Thugmek/ScintillatorProbe/Research/PMT Controller (Dec 2016)/PMT Controller (Dec 2016)/PHOTO/power supply wiring.JPG

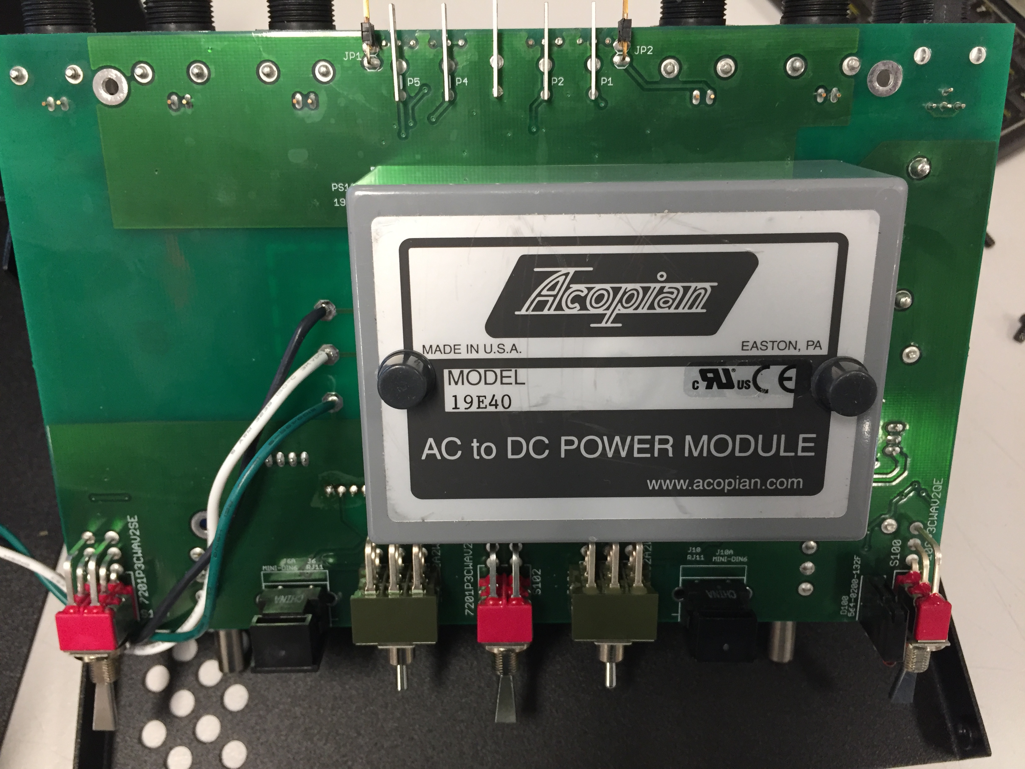
Research/PMT Controller (Dec 2016)/PMT Controller (Dec 2016)/PHOTO/power supply wiring.JPG
