Thugmek/ScintillatorProbe/ScintillatorProbeHardware/ScintillatorProbeHardware-brd.jpg

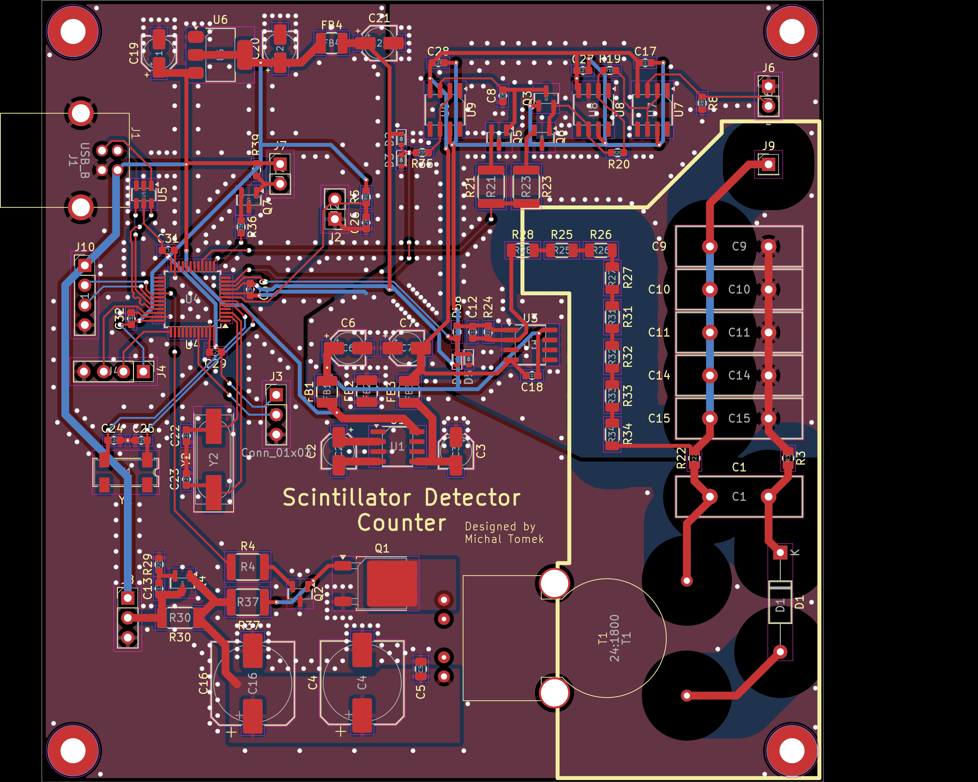
ScintillatorProbeHardware/ScintillatorProbeHardware-brd.jpg
