Thugmek/ScintillatorProbe/README.md

# Scintillator Gamma Detector

## License

All software in this repository is licensed under [GNU GPLv3](https://choosealicense.com/licenses/gpl-3.0/).
All hardware in this repository is licensed under [CERN OHL v2 Permissive](https://choosealicense.com/licenses/cern-ohl-p-2.0/).
