Thugmek/ScintillatorProbe/Research/PMT Controller (Dec 2016)/PMT Controller (Dec 2016)/PHOTO/frontpanel.JPG

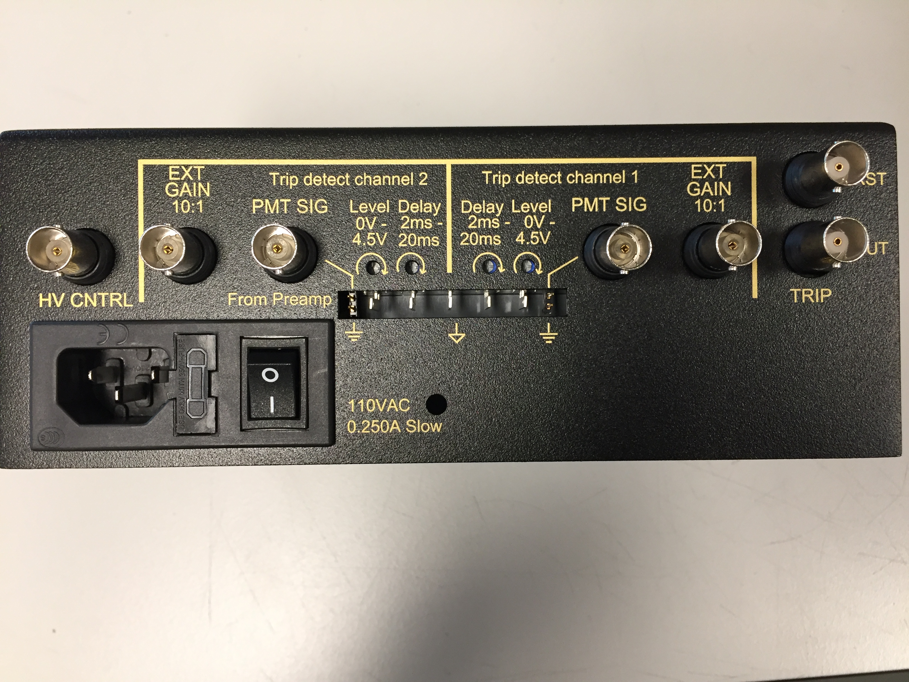
Research/PMT Controller (Dec 2016)/PMT Controller (Dec 2016)/PHOTO/frontpanel.JPG
