Thugmek/ScintillatorProbe/Research/PMT Controller (Dec 2016)/PMT Controller (Dec 2016)/PHOTO/rearpanel.JPG

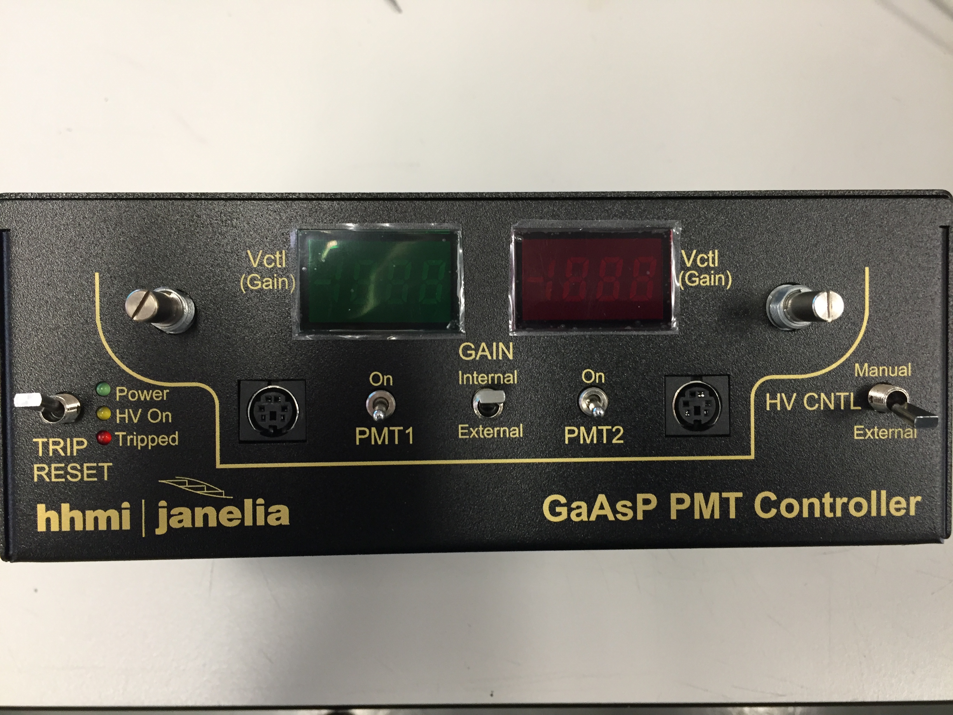
Research/PMT Controller (Dec 2016)/PMT Controller (Dec 2016)/PHOTO/rearpanel.JPG
