Thugmek/ScintillatorProbe/ScintillatorProbeHardware/schematic.png

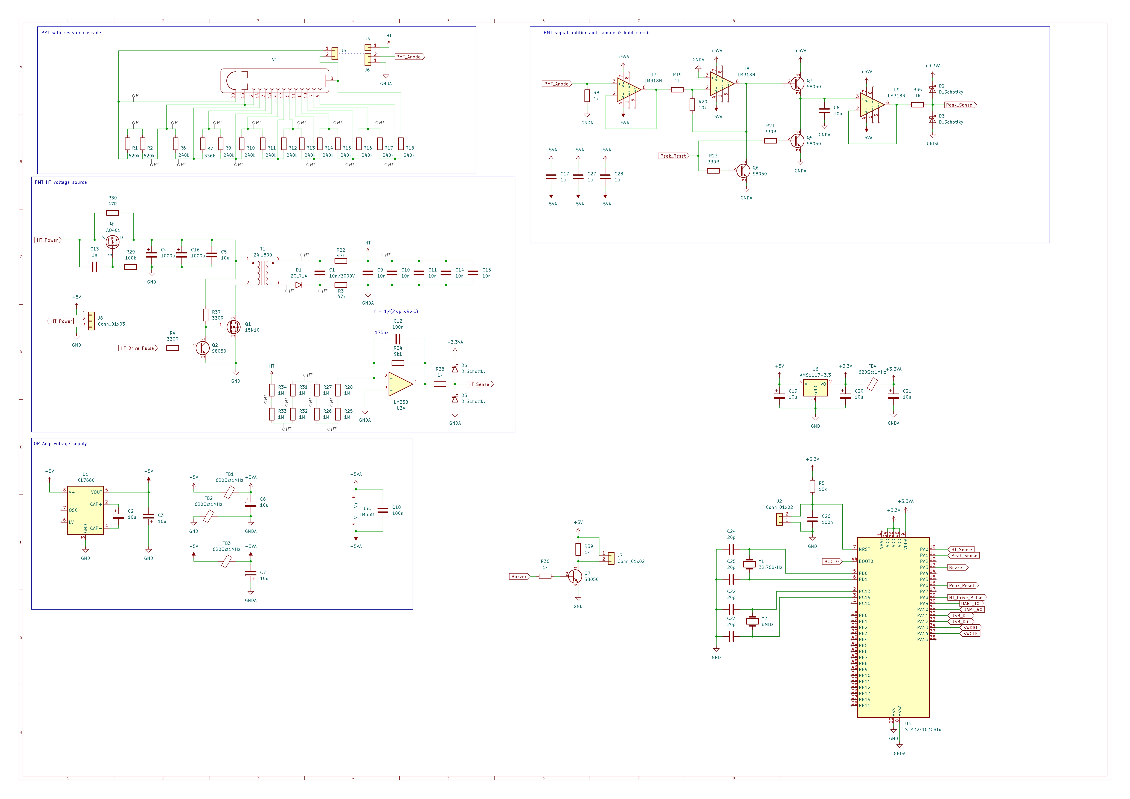
ScintillatorProbeHardware/schematic.png
