Thugmek/ScintillatorProbe/Research/PMT Controller (Dec 2016)/PMT Controller (Dec 2016)/ASSEMBLY/PMT_CNTLR_J002028REVE.xlsx

PMT_CNTLR_J002028REVE BOM
Qty | Value | Device | Manufacturer | Manuafcturer PN | Digi-Key PN | Designators
2 |  | HEADER 1X2 M RA | TE Connectivity | 1-86479-3 | A28782-ND | JP1 JP2
1 |  | HEADER 1X4 M ST | TE Connectivity | 3-644456-4 | A31114-ND | JP3
2 |  | SWITCH-3PDT-VERT3PDT_VERT_RA | NKK | M2032S2A2W40 | 360-2858-ND | S101 S103
2 |  | SWITCH-DPDT ON-NONE-ON | C&K | 7201P3CWAV2SE | CKN9728-ND | S102 S104
1 |  | SWITCH-SPDT ON-NONE-MOM | C&K | 7108P3CWAV2QE | CKN9716-ND | S100
5 |  | TEST POINT | Keystone | 1045 | 1045K-ND | P1 P2 P3 P4 P5
11 | 0.1 | CAPS0805S | KEMET | C0805C104K1RACTU | 399-3486-1-ND | C5 C6 C7 C8 C12 C15 C16 C17 C18 C21 C22
2 | 0R-DNI | RESISTOR_SM0805S | DNI | DNI | DNI | R20 R21/ DNI
5 | 5227161-9 | BNC, PCB , RA, LOW | TE Connectivity | 5227161-9 | A32261-ND | J1 J2 J3 J4 J5
1 |  | CONN BNC JACK R/A PCB | Amphenol | 112705 | ACX2286-ND | J9
5 | 1K | RESISTOR_SM0805S | VISHAY | CRCW08051K00FKEA | 541-1.00KCCT-ND | R7 R9 R33 R34 R38
4 | 1uF/35V | CAPS0805S | MURATA | GRM31CR61H106KA12L | 490-5961-1-ND | C3 C4 C19 C20
8 | 2K | RESISTOR_SM0805S | VISHAY | CRCW08052K00FKEA | 541-2.00KCCT-ND | R5 R6 R16 R17 R18 R22 R26 R27
2 | 10K | POT3362M | Bourns | 3362M-1-103LF | 3362M-103LF-ND | R1 R4
2 | 90K9 | RESISTOR_SM0805S | VISHAY | CRCW080590K9FKEA | 541-90.9KCCT-ND | R31 R32
6 | 10K | RESISTOR_SM0805S | VISHAY | CRCW080510K0FKEA | 541-10.0KCCT-ND | R11 R12 R13 R14 R30 R37
4 | 10uF/35V | CAPS1206S | TAIYO YUDEN | GMK316AB7106KL-TR | 587-3007-1-ND | C9 C10 C13 C14
2 | 16.9K | RESISTOR_SM0805S | VISHAY | CRCW080516K9FKEA | 541-16.9KCCT-ND | R23 R24
1 | 19E40 | ACOPIAN_PS | Acopian | 19E40 | from manufacturer | PS100
2 | 20K | POT3362M | Bourns | 3362M-1-203LF | 3362M-203LF-ND | R2 R3
4 | 20K | RESISTOR_SM0805S | VISHAY | CRCW080520K0FKEA | 541-20.0KCCT-ND | R15 R19 R25 R35
1 | 47pF | CAPS0805S | JOHANSON | 500R15N470JV4T | 709-1175-1-ND | C11
2 | 50K | POT | Bourns | 3590P-4-503L | 3590P-4-503L-ND | R28 R29
1 | 74AHC1G02DBV | 74AHC1G02DBV | TI | SN74AHC1G02DBVR | 296-1088-1-nd | U3
1 | 74AHC1G08DBV | 74AHC1G08DBV | TI | SN74AHC1G08DBVR | 296-1091-1-ND | U8
2 | 100K | RESISTOR_SM0805S | VISHAY | CRCW0805100KFKEA | 541-100KCCT-ND | R8 R10
2 | 470pF | CAPS0805S - NPO | KEMET | C0805C471J5GACTU | 399-1133-2-ND | C1 C2
1 | 564-0200-132F | LED-TRI | DIALIGHT | 564-0200-132F | 350-1755-ND | D100
1 | 74123D | IC MULTIVIBRATOR | NXP | 74HCT123D,653 | 568-9983-1-ND | U6
1 | 74279D | 74279D | TI | SN74LS279ADR | 296-29449-1-ND | U9
1 | ADG436 | ADG436 | ANALOG DEVICES | ADG436BRZ | ADG436BRZ | U10
1 | 7019B-MTG | HEAT_SINK | AAVID | 7019B-MTG | 32-7019B-MT (MOUSER) | HS1
1 |  | HEATSINK FOR TO-220 1.0" | Ohmite | FA-T220-25E | FA-T220-25E-ND | HS2
1 | LM340-5 | VREG_LM340_78X | TI | LM340T-5.0/NOPB | LM340T-5.0/NOPB-ND | U5
1 | LM340-15 | VREG_LM340_78X | TI | LM340T-15/NOPB | LM340T-15/NOPB-ND | U7
2 | FLEX CABLE/PCB | M12PTH | TE Connectivity | AFE12T/AF12/AFE12T | A9AAT-1202F-ND | JP4 JP5
2 | TLC3702 | COMPARATOR - DUAL | TI | TLC3702CDR | 296-1325-1-ND | U1 U2
1 | TS922 | OPAMP | ST MICRO | TS922IDT | 497-6035-1-ND | U11
2 | Mini-DIN | 6 Position Circular Connector Receptacle, | CUI | MD-60S | CP-2460-ND | J6A J10A
3 | SFH6186-2 | OPTOISOLATOR 5.3KV TRANS 4SMD | Vishay | SFH6186-2 | SFH6186-2-ND | OK1 OK2 OK3
1 |  | DIODE ARRAY SCHOTTKY 30V SOT23-3 | Diodes | BAT54A-7-F | BAT54A-FDICT-ND | D1
4 |  | HEADER-1X6-F | SAMTEC | SSQ-106-01-G-S | SAM1180-06-ND | ON DISPLAY BOARD
6 |  | FERRITE- 0805-10uH | KEMET | L0805R100KPWST | 399-9588-1-ND | ON DISPLAY BOARD
1 |  | DMM LED RED | MURATA | DMS-20PC-1-RS-C | 811-1001-ND | ON DISPLAY BOARD
1 |  | DMM LED GRN | MURATA | DMS-20PC-1-GS-C | 811-1009-ND | ON DISPLAY BOARD
1 |  | POWER ENTRY MODULE | DELTA | 06AR2D | 603-1132-ND | ON CHASSIS
3 |  | CONN RECEPT FASTON 18-22AWG 250 | TE Connectivity | 2-520183-2 | A27817CT-ND | WIRED TO BOARD
1 |  | FUSE GLASS 250MA 250VAC 5X20MM | Littelfuse | 0218.250HXP | F2413-ND | Mount in Power Entry Module
2 |  | FLEX CABLE - AFE12T/AF12/AFE12T | TE Connectivity | A9AAT-1202F | A9AAT-1202F-ND | Connects LCD dipsalay to board
2 | Knob | SWITCH KNOB STRGHT 0.75" BLACK | TE Connectivity | KB700B1/4 | KB700B1/4-ND | Mounts to potentiometer
1 | Wire | 18 AWG Hook-Up Wire 34/0.0071" Black 600V 25.0' | CNC Tech | 3135-18-1-0500-001-1-TS | CN103B-25-ND | Hot connection
1 | Wire | 18 AWG Hook-Up Wire 34/0.0071" White 600V 25.0' | CNC Tech | 3135-18-1-0500-002-1-TS | CN103W-25-ND | Neutral Connection
1 | Wire | 18 AWG Hook-Up Wire 34/0.0071" Green 600V 25.0' | CNC Tech | 3135-18-1-0500-007-1-TS | CN103G-25-ND | Ground Connection
 | Alternate to J6A, J10A, requires enlarging chassis cutout height | Jack Modular Connector 6p4c (RJ11, RJ14) | Hirose | TM2REA-0604(50) | H11296-ND | J6 J10
