Thugmek/ScintillatorProbe/Research/PMT Controller (Dec 2016)/PMT Controller (Dec 2016)/ASSEMBLY/PMT_CNTLR_J002028REVE_toppcb.pdf

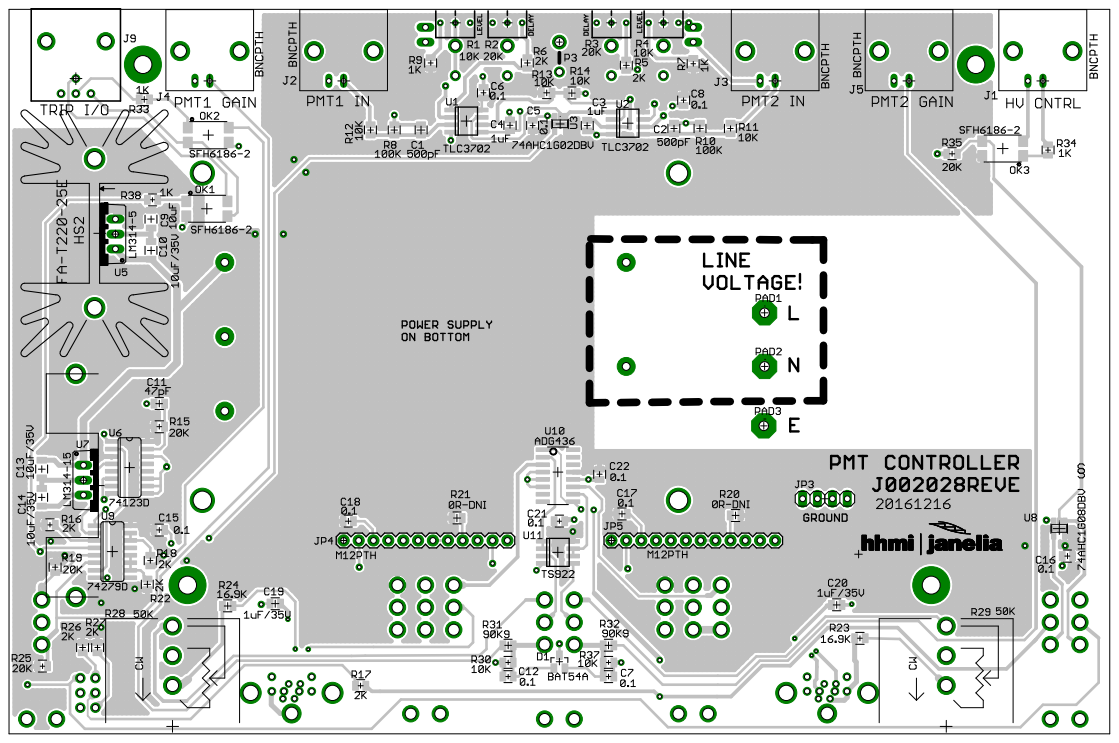
[picture p18: page 1]
