Thugmek/ScintillatorProbe/Research/PMT Controller (Dec 2016)/PMT Controller (Dec 2016)/ECAD/PMT_CNTLR_J002028REVE_schematic.pdf

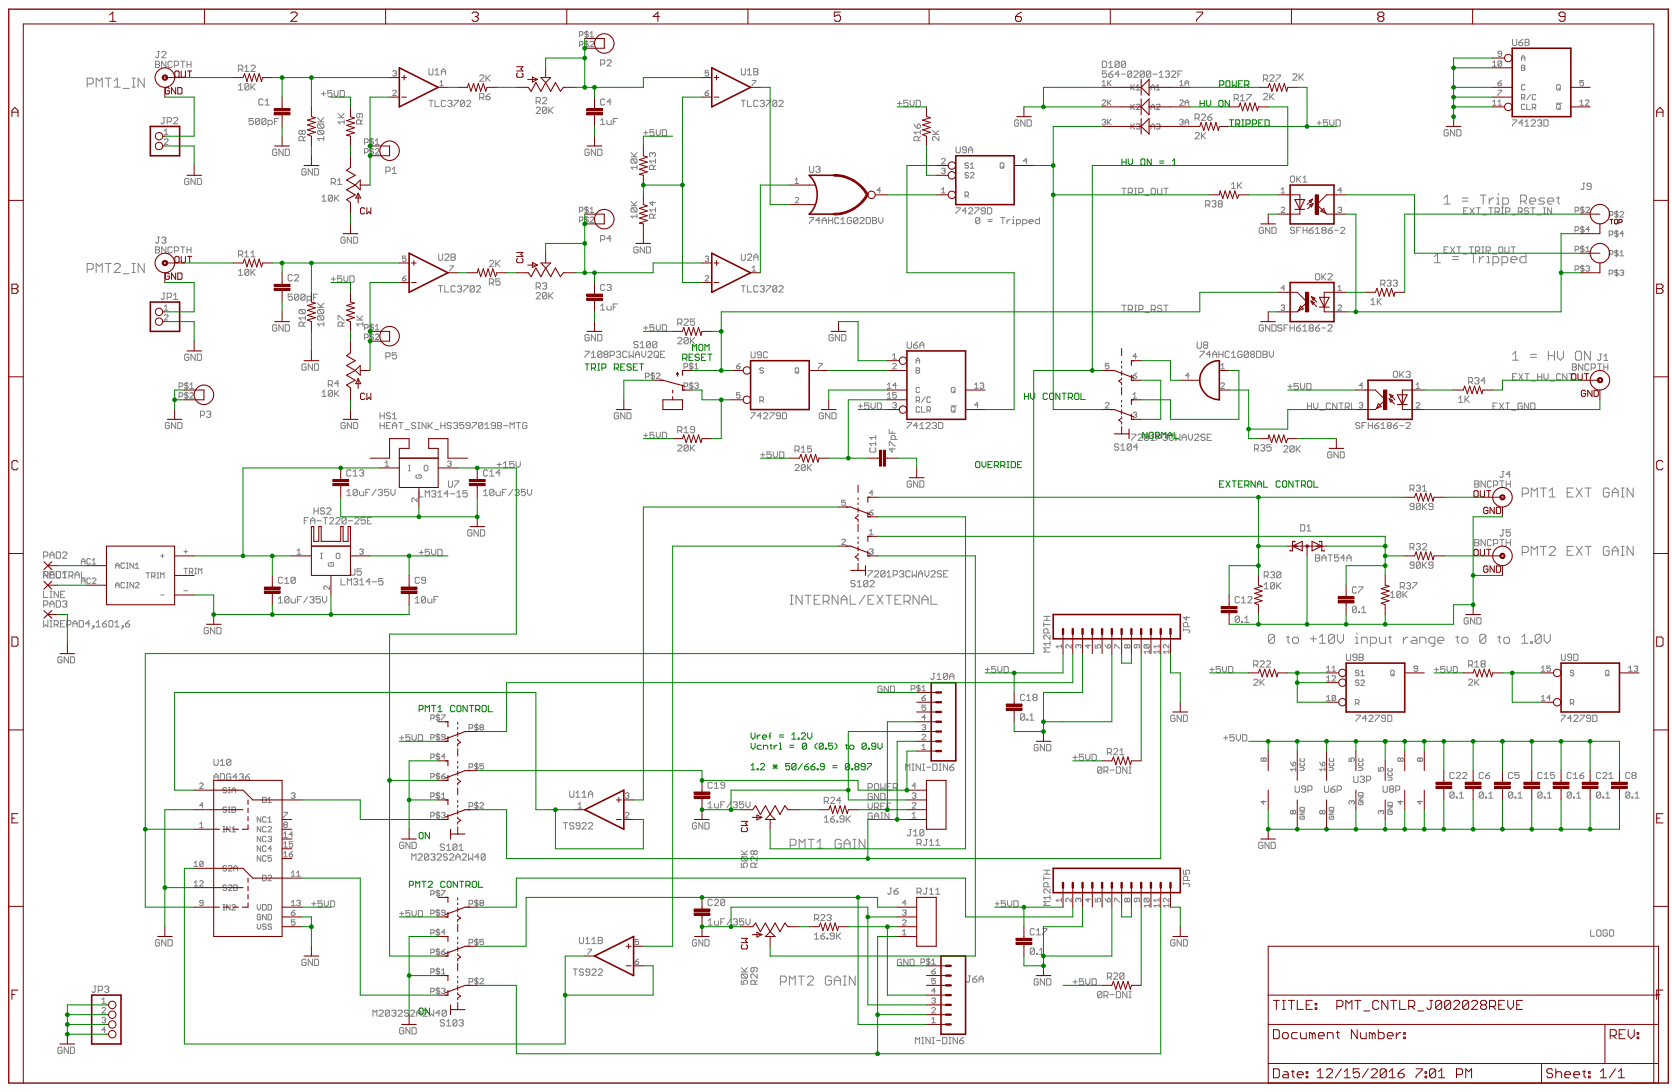
[picture p19: page 1]
