Thugmek/ScintillatorProbe/ScintillatorProbeHardware/ScintillatorProbeHardware.kicad_pcb

## KiCad design ScintillatorProbeHardware/ScintillatorProbeHardware.kicad_pcb (2025-03-03)

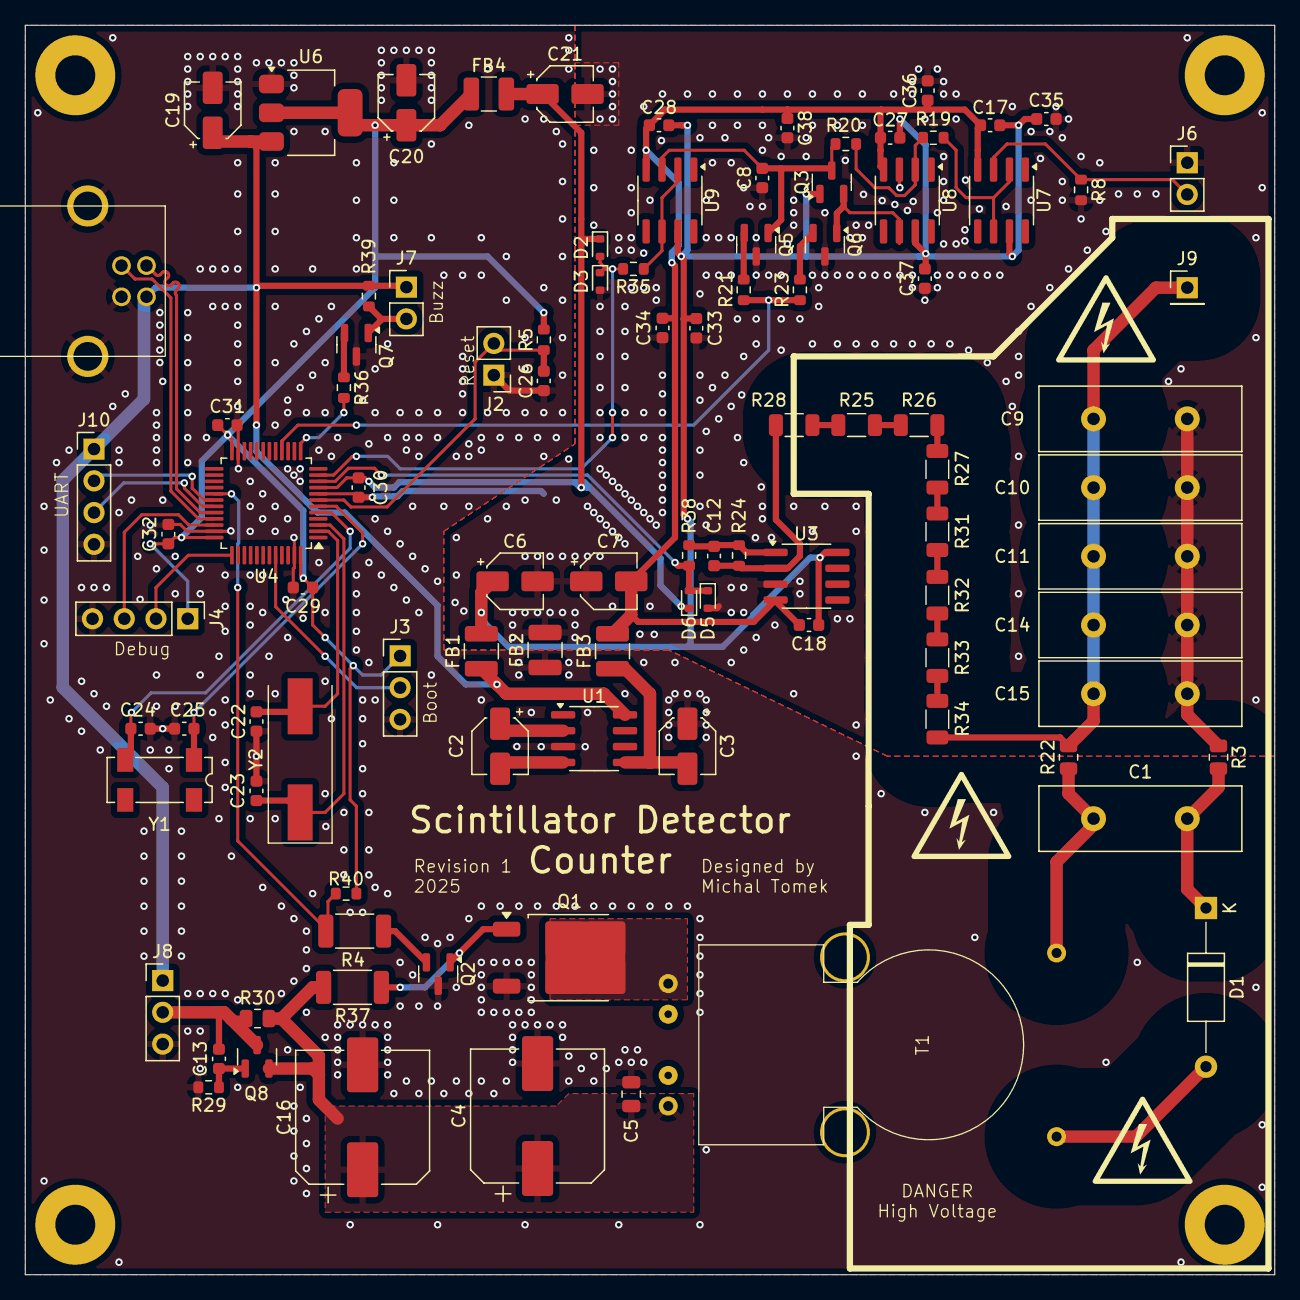
[picture p20: board ScintillatorProbeHardware.kicad_pcb from above]

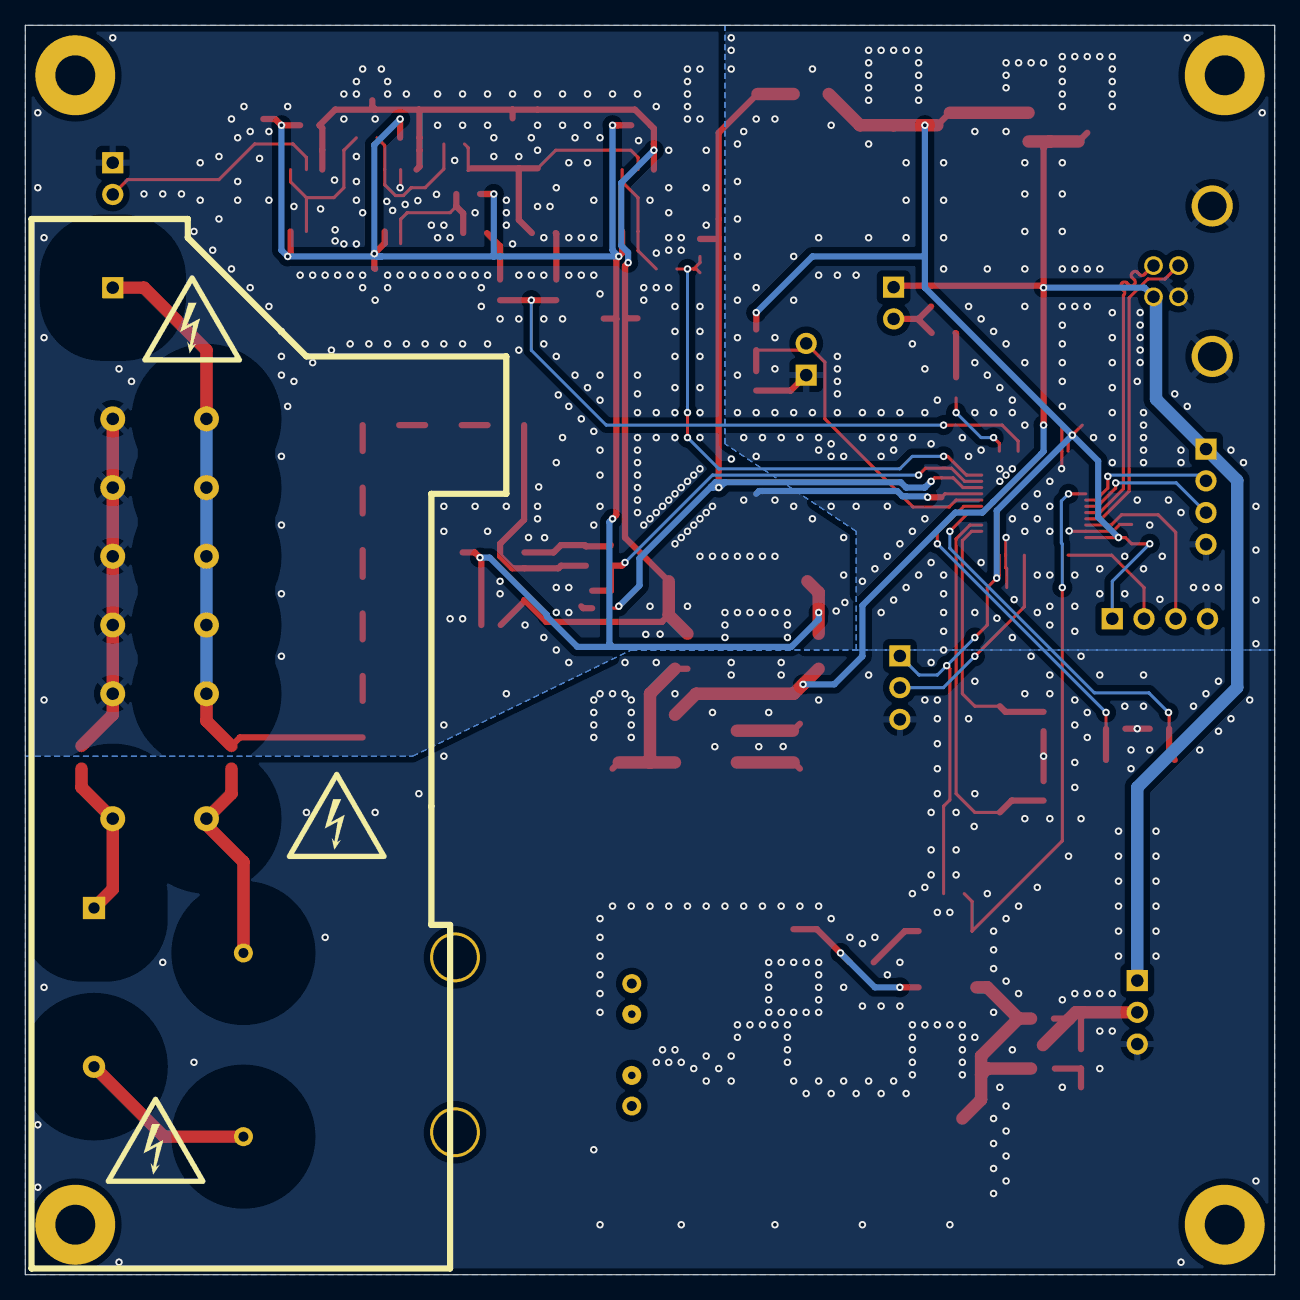
[picture p21: board ScintillatorProbeHardware.kicad_pcb from below]

Board: 2 copper layers, 100.0 x 100.0 mm, 109 parts (3 on the bottom side), 56 nets.

Parts:
C1: 10n/3000V; C_Disc_D16.0mm_W5.0mm_P7.50mm
C2, C3, C6, C7, C19, C20, C21: 10u; CP_Elec_4x5.4
C4, C16: 1000u; CP_Elec_10x10.5
C5: 10u; C_0805_2012Metric
C8: 10n; C_0603_1608Metric
C9, C10, C11, C14, C15: 10n; C_Disc_D16.0mm_W5.0mm_P7.50mm
C12, C18, C26: 100n; C_0603_1608Metric
C13, C17, C27, C28, C29, C30, C31, C32, C33, C34, C35, C36, C37, C38: 1u; C_0603_1608Metric
C22, C23, C24, C25: 20p; C_0603_1608Metric
D1: 2CL71A; D_A-405_P12.70mm_Horizontal
D2, D3, D5, D6: D_Schottky; D_SOD-523
FB1, FB2, FB3, FB4: 620Ω@1MHz; L_1210_3225Metric
H1, H2, H3, H4: MountingHole; MountingHole_3.2mm_M3_Pad
J1: USB_B; Amphenol_USB_B
J2, J7: Conn_01x02; PinHeader_1x02_P2.54mm_Vertical
J3, J8: Conn_01x03; PinHeader_1x03_P2.54mm_Vertical
J4, J10: Conn_01x04; PinHeader_1x04_P2.54mm_Vertical
J6: PinHeader_1x02_P2.54mm_Vertical
J9: Conn_01x01; PinHeader_1x01_P2.54mm_Vertical
Q1: 15N10; TO-252-2
Q2, Q3, Q5, Q6, Q7: S8050; SOT-23
Q8: MDD2302; SOT-23
R3, R22: 47k; R_0805_2012Metric
R4, R37: 330R; R_2010_5025Metric
R5, R20: 10k; R_0603_1608Metric
R8, R19, R35, R36, R38, R39, R40: 1k; R_0603_1608Metric
R21, R23: 330R; R_0603_1608Metric
R24: 9k1; R_0603_1608Metric
R25, R26, R27, R28, R31, R32, R33, R34: 1M; R_1206_3216Metric
R29: 100k; R_0603_1608Metric
R30: 47R; R_0805_2012Metric
SYM1, SYM2, SYM3, SYM4, SYM5, SYM6: SYM_Flash_Small; W012 - electricity hazard
T1: 24:1800; 15kV_Transformer
U1: ICL7660; SOIC-8_3.9x4.9mm_P1.27mm
U3: LM358; SOIC-8_3.9x4.9mm_P1.27mm
U4: STM32F103C8Tx; LQFP-48_7x7mm_P0.5mm
U6: AMS1117-3.3; SOT-223-3_TabPin2
U7, U8, U9: LM318N; SOIC-8_3.9x4.9mm_P1.27mm
Y1: 32.768kHz; Crystal_SMD_SeikoEpson_MC306-4Pin_8.0x3.2mm
Y2: 8MHz; Crystal_SMD_HC49-SD

Connections:
+3.3V: C20.1, C29.2, C31.2, C32.2, FB4.1, J3.1, J4.1, R5.2, R40.1, U4.24 (VDD), U4.36 (VDD), U4.48 (VDD), U6.2 (VO)
+3.3VA: C21.1, C30.2, D2.1 (K), D6.1 (K), FB4.2, U4.9 (VDDA)
+5V: C19.1, FB1.1, J1.1 (VBUS), J7.1, J8.1, J10.1, R39.1, U1.8 (V+), U6.3 (VI)
+5VA: C6.1, C17.2, C18.2, C27.2, C28.2, C33.2, C35.2, C37.2, FB1.2, Q3.1 (C), U3.8 (V+), U7.7 (V+), U8.7 (V+), U9.7 (V+)
-5V: C3.2, FB3.1, U1.5 (VOUT)
-5VA: C7.2, C17.1, C18.1, C27.1, C28.1, C34.1, C36.1, C38.1, FB3.2, U3.4 (V-), U7.4 (V-), U8.4 (V-), U9.4 (V-)
BOOT0: J3.2, U4.44 (BOOT0)
Buzzer: R36.2, U4.13 (PA3)
GND: C3.1, C4.2, C5.2, C16.2, C19.2, C20.2, C22.1, C23.1, C24.1, C25.1, C26.1, C29.1, C31.1, C32.1, FB2.1, J1.4 (GND), J1.5 (Shield), J2.1, J3.3, J4.4, J8.3, J10.4, Q1.3 (S), Q2.3 (E), Q7.3 (E), R29.2, U1.3 (GND), U4.23 (VSS), U4.35 (VSS), U4.47 (VSS), U6.1 (GND)
GNDA: C6.2, C7.1, C8.1, C9.2, C10.2, C11.2, C14.2, C15.2, C21.2, C30.1, C33.1, C34.2, C35.1, C36.2, C37.1, C38.2, D3.2 (A), D5.2 (A), FB2.2, J6.1, Q5.3 (E), Q6.3 (E), R3.1, R8.2, U3.3 (+), U4.8 (VSSA), U8.3 (+)
HT: C9.1, C10.1, C11.1, C14.1, C15.1, J9.1, R22.2, R34.2
HT_Drive_Pulse: R4.1, R40.2, U4.29 (PA8)
HT_Power: C13.1, J8.2, Q8.3 (D), R30.1
HT_Sense: D5.1 (K), D6.2 (A), R38.2, U4.10 (PA0)
unnamed: C12.2, R24.1, R38.1, U3.1
unnamed: D1.2 (A), T1.3 (SA)
unnamed: C1.2, D1.1 (K), R3.2
unnamed: C26.2, J2.2, R5.1, U4.7 (NRST)
unnamed: J7.2, Q7.1 (C), R39.2
unnamed: Q1.2 (D), T1.2 (AB)
unnamed: Q1.1 (G), Q2.1 (C), R37.1
unnamed: Q2.2 (B), R4.2
unnamed: Q3.2 (B), Q6.1 (C), U8.6
unnamed: C8.2, Q3.3 (E), Q5.1 (C), R20.2, U9.3 (+)
unnamed: Q5.2 (B), R21.2
unnamed: Q6.2 (B), R23.2
unnamed: Q7.2 (B), R36.1
unnamed: C13.2, Q8.1 (G), R29.1
unnamed: C4.1, C5.1, C16.1, Q8.2 (S), R30.2, R37.2, T1.1 (AA)
unnamed: R25.1, R26.1
unnamed: R25.2, R28.1
unnamed: R26.2, R27.1
unnamed: R27.2, R31.2
unnamed: R31.1, R32.2
unnamed: R32.1, R33.1
unnamed: R33.2, R34.1
unnamed: C1.1, R22.1, T1.4 (SB)
unnamed: C2.1, U1.2 (CAP+)
unnamed: C2.2, U1.4 (CAP-)
unnamed: C12.1, R24.2, R28.2, U3.2 (-)
unnamed: C22.2, U4.2 (PC13), Y2.2
unnamed: C23.2, U4.3 (PC14), Y2.1
unnamed: C24.2, U4.5 (PD0), Y1.2
unnamed: C25.2, U4.6 (PD1), Y1.1
unnamed: R19.1, U7.2 (-), U7.6
unnamed: R19.2, R20.1, U8.2 (-)
unnamed: R35.1, U9.2 (-), U9.6
PMT_Anode: J6.2, R8.1, U7.3 (+)
Peak_Reset: R21.1, R23.1, U4.16 (PA6)
Peak_Sense: D2.2 (A), D3.1 (K), R35.2, U4.11 (PA1)
SWCLK: J4.2, U4.37 (PA14)
SWDIO: J4.3, U4.34 (PA13)
UART_RX: J10.3, U4.31 (PA10)
UART_TX: J10.2, U4.30 (PA9)
USB_D+: J1.3 (D+), U4.33 (PA12)
USB_D-: J1.2 (D-), U4.32 (PA11)
