Thugmek/ScintillatorProbe/ScintillatorProbeSoftware/Core/Src/main.c

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
/* Includes ------------------------------------------------------------------*/
#include "main.h"
#include "usb_device.h"

/* USER CODE BEGIN Includes */
#include "usbd_cdc_if.h"
#include <string.h>
#include <math.h>
/* USER CODE END Includes */

/* USER CODE BEGIN PTD */
typedef struct GcodeArgument {
    char name;
    float value;
} GcodeArgument;

typedef struct Gcode {
    int valid;
    char letter;
    int number;
    int arg_len;
    GcodeArgument arguments[32];
} Gcode;
/* USER CODE END PTD */

/* USER CODE BEGIN PM */
#define ADC_TO_VOLTAGE 0.7510653409
#define MAX_PWM 1200

#define PEAK_THRESSHOLD 50
#define PEAK_RESET_SAMPLES 3

#define REPORT_CHUNK 100
#define REPORT_DECIMATION 10
/* USER CODE END PM */

ADC_HandleTypeDef hadc1;
ADC_HandleTypeDef hadc2;

TIM_HandleTypeDef htim1;
TIM_HandleTypeDef htim2;
TIM_HandleTypeDef htim3;

/* USER CODE BEGIN PV */
int pwm_value = 0;

float target_voltage = 0.0;

uint32_t peak_height = 0;
uint32_t peak_reset_counter = 0;

uint16_t voltage_history[REPORT_CHUNK];
uint16_t pwm_history[REPORT_CHUNK];
uint16_t history_index = 0;
uint16_t decimation_index = 0;
/* USER CODE END PV */

void SystemClock_Config(void);
static void MX_GPIO_Init(void);
static void MX_TIM1_Init(void);
static void MX_ADC1_Init(void);
static void MX_ADC2_Init(void);
static void MX_TIM2_Init(void);
static void MX_TIM3_Init(void);
/* USER CODE BEGIN 0 */
uint8_t TxBuffer[] = "Hello World! From STM32 USB CDC Device To Virtual COM Port\r\n";
uint8_t TxBufferLen = sizeof(TxBuffer);
/* USER CODE END 0 */

/**
  * @brief  The application entry point.
  * @retval int
  */
int main(void)
{

  /* MCU Configuration--------------------------------------------------------*/

  /* Reset of all peripherals, Initializes the Flash interface and the Systick. */
  HAL_Init();

  /* Configure the system clock */
  SystemClock_Config();

  /* Initialize all configured peripherals */
  MX_GPIO_Init();
  MX_USB_DEVICE_Init();
  MX_TIM1_Init();
  MX_ADC1_Init();
  MX_ADC2_Init();
  MX_TIM2_Init();
  MX_TIM3_Init();
  /* USER CODE BEGIN 2 */
  TIM1->CCR1 = 1400;
  TIM2->CCR4 = 300;
  HAL_TIM_PWM_Start(&htim1, TIM_CHANNEL_1);
  HAL_TIM_PWM_Start(&htim2, TIM_CHANNEL_4);
  HAL_TIM_Base_Start_IT(&htim3);
  HAL_ADC_Start_IT(&hadc1);
  HAL_ADC_Start_IT(&hadc2);
  /* USER CODE END 2 */

  /* Infinite loop */
  /* USER CODE BEGIN WHILE */
  while (1)
  {
    /* USER CODE END WHILE */

    /* USER CODE BEGIN 3 */
	//CDC_Transmit_FS(TxBuffer, TxBufferLen);
	//HAL_Delay(1000);
  }
  /* USER CODE END 3 */
}

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
/* USER CODE BEGIN 4 */

Gcode parse_gcode(char* buff, int len){
    Gcode gcode;
    gcode.valid = 1;
    gcode.arg_len = 0;
    char* index = buff;

    if(buff[0] >= 'A' && buff[0] <= 'Z'){
        gcode.letter = buff[0];
    }else if(buff[0] >= 'a' && buff[0] <= 'z'){
        gcode.letter = buff[0] - ('a'-'A');
    }else{
        gcode.valid = 0;
        return gcode;
    }
    index++;

    gcode.number = 0;
    while(index < buff+len){
        if(*index >= '0' && *index <= '9'){
            gcode.number = gcode.number*10 + (*index - '0');
        }else if (*index == ' ' || *index == '\n'){
            index++;
            break;
        }else{
            gcode.valid = 0;
            return gcode;
        }
        index++;
    }

    int arg_index = -1;
    int inside_arg = 0;
    int decimals = 0;
    while(index < buff+len){
        if(inside_arg){
            if(*index >= '0' && *index <= '9'){
                if(decimals == 0){
                    gcode.arguments[arg_index].value = gcode.arguments[arg_index].value*10 + (*index - '0');
                }else{
                    gcode.arguments[arg_index].value = gcode.arguments[arg_index].value + ((float)(*index - '0') * pow(0.1,decimals));
                    decimals++;
                }
            }else if(*index == '.'){
                if(decimals > 0){
                    gcode.valid = 0;
                    return gcode;
                }
                decimals = 1;
            }else if (*index == ' '){
                decimals = 0;
                inside_arg = 0;
            }else if(*index == '\n'){
                return gcode;
            }else{
                gcode.valid = 0;
                return gcode;
            }
        }else{
            if(*index >= 'A' && *index <= 'Z'){
                arg_index++;
                gcode.arguments[arg_index].name = *index;
                gcode.arguments[arg_index].value = 0;
                gcode.arg_len = arg_index+1;
                inside_arg = 1;
            }else if(*index >= 'a' && *index <= 'z'){
                arg_index++;
                gcode.arguments[arg_index].name = *index - ('a' - 'A');
                gcode.arguments[arg_index].value = 0;
                inside_arg = 1;
            }else if (*index == ' '){

            }else if (*index == '\n'){
                return gcode;
            }else{
                gcode.valid = 0;
                return gcode;
            }

        }
        index++;
    }

    return gcode;
}

int get_gcode_arg(Gcode* gcode, char arg_name, float* out){
	int i = 0;
	while(i<gcode->arg_len){
		if(gcode->arguments[i].name == arg_name){
			*out = gcode->arguments[i].value;
			return 1;
		}
		i++;
	}
	return 0;
}

void USB_CDC_RxHandler(uint8_t* Buf, uint32_t Len)
{
	Gcode gcode = parse_gcode((char*)Buf, Len);

	char TxBuffer[1024];
	if(Buf[0] == 'A'){
		float value = atof((char*)(Buf+1));
		sprintf(TxBuffer, "Received data starting with A and value %f\n", value);
	}else if (Buf[0] == 'B'){
		int value = atoll((char*)(Buf+1));
		sprintf(TxBuffer, "Received data starting with B and value %i\n", value);
	}else{
		sprintf(TxBuffer, "Received data not starting with A or B '%s' with len %i\n", Buf, (int)Len);
	}

	if(gcode.letter == 'P'){
		switch(gcode.number){
			case 1:
				float val = 0;
				if(get_gcode_arg(&gcode,'A', &val)){
					TIM1->CCR1 = 1400-(int)val;
					sprintf(TxBuffer, "Called P1 - set pwm to %ld\n", 1400-TIM1->CCR1);
				}else{
					sprintf(TxBuffer, "Called P1 - actual pwm: %ld\n",1400-TIM1->CCR1);
				}
				break;
			case 2:
				if(get_gcode_arg(&gcode,'V', &target_voltage)){
					sprintf(TxBuffer, "Called P1 - set voltage to %4.2f\n", target_voltage);
				}else{
					sprintf(TxBuffer, "Called P1 - actual voltage: %4.2f\n",target_voltage);
				}
				break;
		}
	}

	uint32_t l = strlen(TxBuffer);
    CDC_Transmit_FS((uint8_t*)TxBuffer, l);
}

//Sample rate 55_555kHz
void HAL_ADC_ConvCpltCallback(ADC_HandleTypeDef* hadc)
{
	if(hadc == &hadc1){
		// Read & Update The ADC Result
		uint32_t raw_adc = HAL_ADC_GetValue(&hadc1);

		float voltage = raw_adc*ADC_TO_VOLTAGE;

		if(decimation_index >= REPORT_DECIMATION){
			voltage_history[history_index] = (uint16_t)voltage;
			pwm_history[history_index] = 1400 - TIM1->CCR1;
			history_index++;
			decimation_index = 0;
		}

		if(history_index >= REPORT_CHUNK){
			history_index = 0;
			char TxBuffer[1024];
			sprintf(TxBuffer, "R1: %i\n",REPORT_CHUNK);
			uint32_t l = strlen(TxBuffer);
			memcpy(TxBuffer+l, voltage_history, sizeof(uint16_t)*REPORT_CHUNK);
			memcpy(TxBuffer+l + sizeof(uint16_t)*REPORT_CHUNK, pwm_history, sizeof(uint16_t)*REPORT_CHUNK);
			TxBuffer[l + sizeof(uint16_t)*(REPORT_CHUNK*2)] = '\n';
			CDC_Transmit_FS((uint8_t*)TxBuffer, l + sizeof(uint16_t)*(REPORT_CHUNK*2) + 1);
		}
		decimation_index++;
	}else if(hadc == &hadc2){
		if(peak_reset_counter == 0){
			uint32_t raw_adc = HAL_ADC_GetValue(&hadc2);
			if(raw_adc >= PEAK_THRESSHOLD){
				if(raw_adc > peak_height){
					peak_height = raw_adc;
				}else{
					char TxBuffer[1024];
					sprintf(TxBuffer, "R2:%lu\n",peak_height);
					uint32_t l = strlen(TxBuffer);
					CDC_Transmit_FS((uint8_t*)TxBuffer, l);
					peak_height = 0;
					peak_reset_counter = PEAK_RESET_SAMPLES;
					HAL_GPIO_WritePin(GPIOA, GPIO_PIN_6, GPIO_PIN_SET);
					TIM2->CCR4 = 300;
					HAL_TIM_Base_Start_IT(&htim3);
				}
			}
		}else{
			peak_reset_counter--;
			if(peak_reset_counter == 0){
				HAL_GPIO_WritePin(GPIOA, GPIO_PIN_6, GPIO_PIN_RESET);
			}
		}
	}
}

void HandleTim3(void){
	TIM2->CCR4 = 0;
	HAL_TIM_Base_Stop_IT(&htim3);
}

/* USER CODE END 4 */
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
