Thugmek/ScintillatorProbe/(commit log)

2025-01-17 USB interface working; Command parser; PWM generator
    [ScintillatorProbeHardware.kicad_sch]
2025-01-18 Voltage read-out
2025-01-19 PID regulator (not tuned)
2025-01-20 KiCad .gitignore
2025-01-20 Flyback driving circuit changed to NMOS
    [ScintillatorProbeHardware.kicad_sch]
2025-01-20 Controll app PID page started
2025-01-21 Debug voltages and PWM
2025-01-21 Voltage read-out chart
2025-01-21 Controllable PWM form App
2025-01-24 Added some LCSC numbers
    [ScintillatorProbeHardware.kicad_sch]
2025-01-27 Removed research materials
2025-02-02 Peak detector circuit simulation
2025-02-22 added transformer model; experiments with beeping code
    [ScintillatorProbeHardware.kicad_sch]
2025-02-23 PCB layout started, firmware modified for new peak detector
    [ScintillatorProbeHardware.kicad_pcb, ScintillatorProbeHardware.kicad_sch]
2025-02-23 Pulse beeping; minor fixes
    [MeasurementPage.py, PIDPage.py, ScintilatorProbeSoftware.ioc, SerialHandler.py, main.c]
2025-02-28 PCB mostly routed
    [ScintillatorProbeHardware.kicad_pcb, ScintillatorProbeHardware.kicad_sch]
2025-02-28 Added USB connector, some loops on PCB optimized
    [PMT_CNTLR_J002028REVE.xlsx, ScintillatorProbeHardware.kicad_pcb, ScintillatorProbeHardware.kicad_sch]
2025-02-28 Hardware finisnig touches, Software directory typo fixed
    [ScintillatorProbeHardware.kicad_pcb, ScintillatorProbeHardware.kicad_sch]
2025-03-03 Hardware revision 1 as sent to manifacture
    [ScintillatorProbeHardware.kicad_pcb, ScintillatorProbeHardware.kicad_sch, bom.csv, designators.csv, positions.csv]
